topnie/automated_greenhouse/images/render1.png

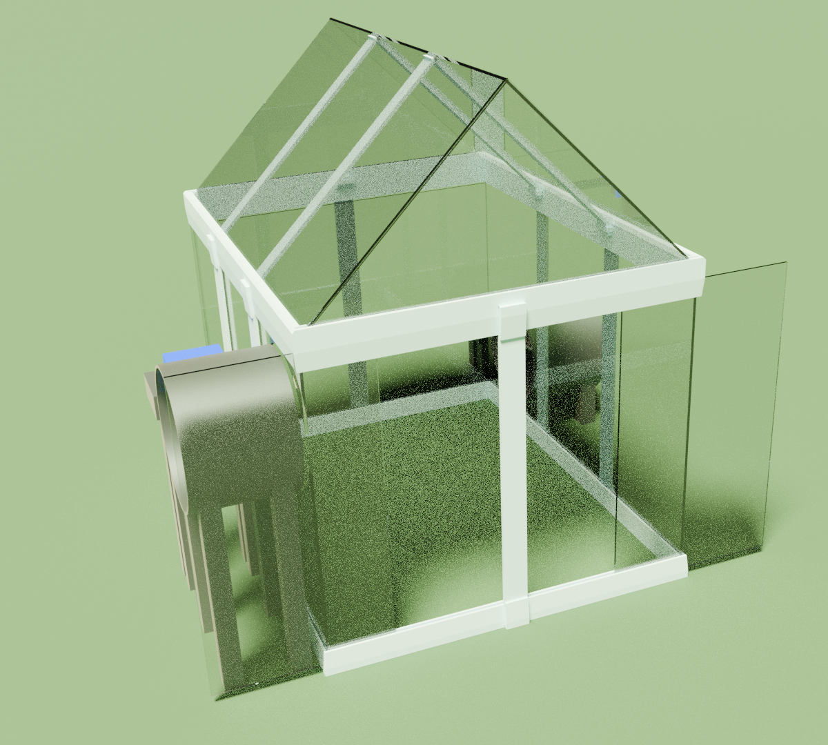
images/render1.png
