topnie/automated_greenhouse/images/render2.png

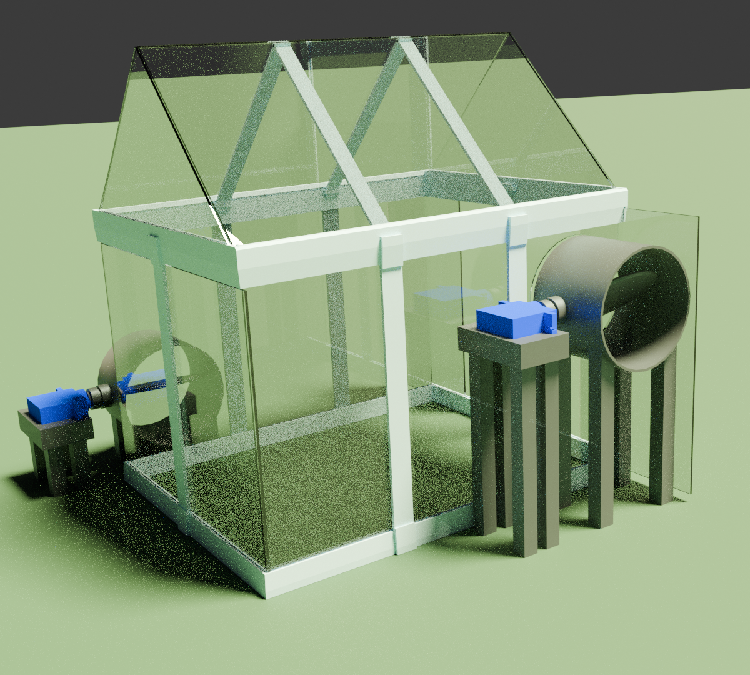
images/render2.png
