topnie/automated_greenhouse/images/render3.png

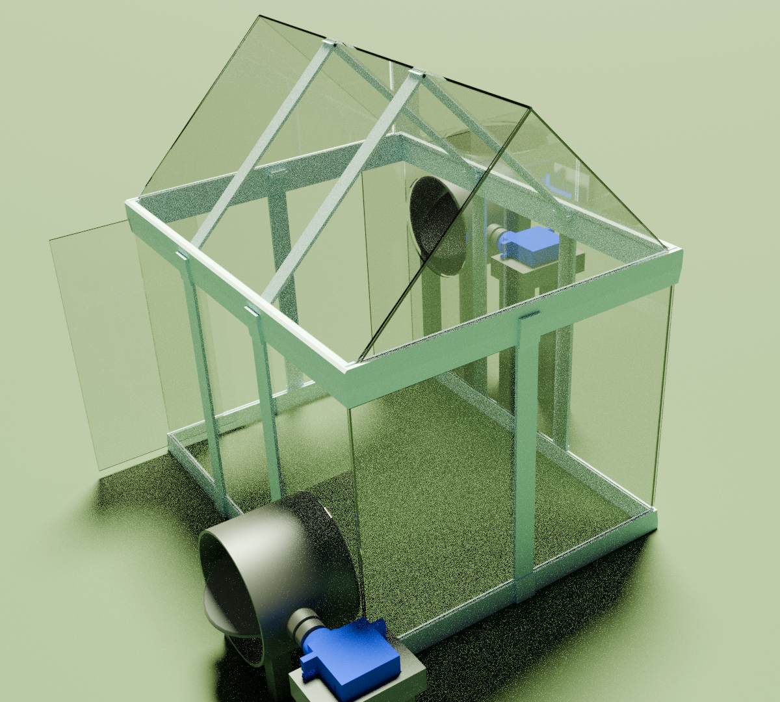
images/render3.png
