topnie/automated_greenhouse/images/side_view.jpg

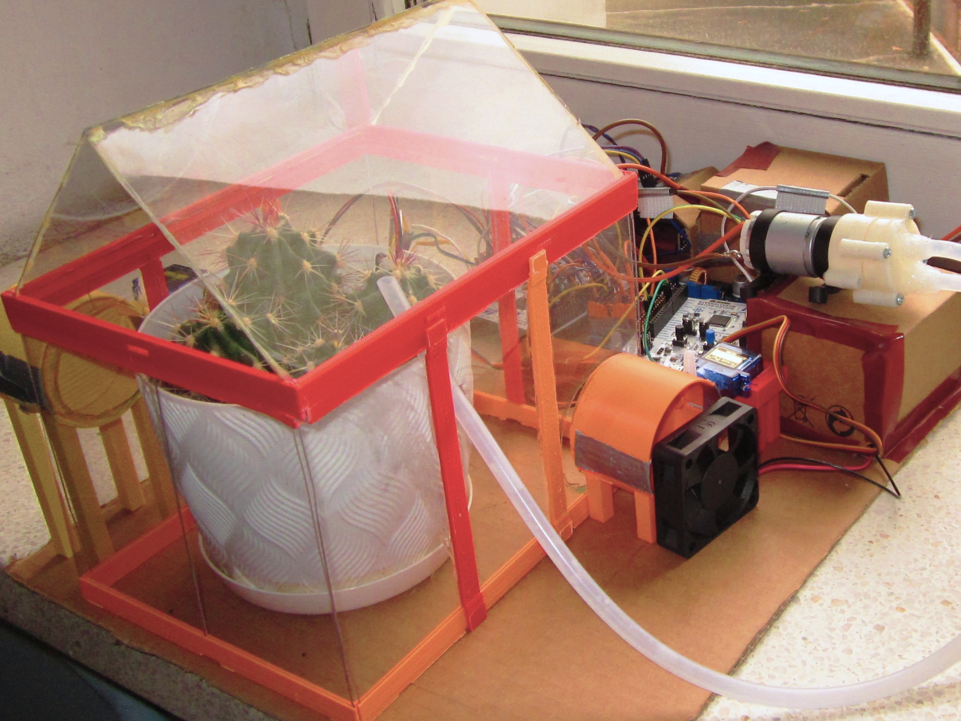
images/side_view.jpg
