topnie/automated_greenhouse/parts/bom.csv

item | part_name | manufacturer | model_or_part_number | quantity | purchase_unit
1 | STM32 NUCLEO-G431RB Development Board | STMicroelectronics | NUCLEO-G431RB | 2 | pcs
2 | Waveshare SN65HVD230 CAN Bus Transceiver Module | Waveshare | SN65HVD230 / 3945 | 2 | pcs
3 | BH1750 Digital Ambient Light Sensor Module |  | BH1750 | 1 | pcs
4 | DFRobot SHT31-F Digital Temperature and Humidity Sensor (I2C) | DFRobot | SEN0334 | 1 | pcs
5 | Cytron Maker Capacitive Soil Moisture Sensor | Cytron | Maker Soil Moisture | 1 | pcs
6 | XL4015 DC-DC Buck Converter, 1.3–36 V, 5 A |  | XL4015 | 1 | pcs
7 | 12 V Liquid Pump, 110 L/h, 7 mm Hose Connection |  | 12 V / 110 L/h / 7 mm | 1 | pcs
8 | 1N5819 Schottky Diode, 1 A, 40 V |  | 1N5819 | 2 | pcs
9 | DC Female Barrel Jack Socket, 5.5 × 2.1 mm with Screw Terminals |  | 5.5 × 2.1 mm DC jack | 1 | pcs
10 | MW Power 12 V / 5 A (60 W) Power Supply, 5.5 × 2.1 mm DC Plug | MW Power | 12 V / 5 A / 60 W | 1 | pcs
11 | SUNON MF50151VX-1000U-A99 Fan, 12 V, 50 × 50 × 15 mm | SUNON | MF50151VX-1000U-A99 | 1 | pcs
12 | SG90 Micro Servo, 180° |  | SG90 | 2 | pcs
13 | IRLB8721PBF N-Channel Power MOSFET |  | IRLB8721PBF | 2 | pcs
14 | BME280 Temperature, Humidity and Pressure Sensor Module (I2C/SPI) |  | BME280 | 1 | pcs
15 | Waveshare USB-to-UART TTL Converter, USB Type-C, PL2303 | Waveshare | PL2303 / 20645 | 1 | pcs
