topnie/automated_greenhouse/3d_models/vent_servo_holder_tall.stl

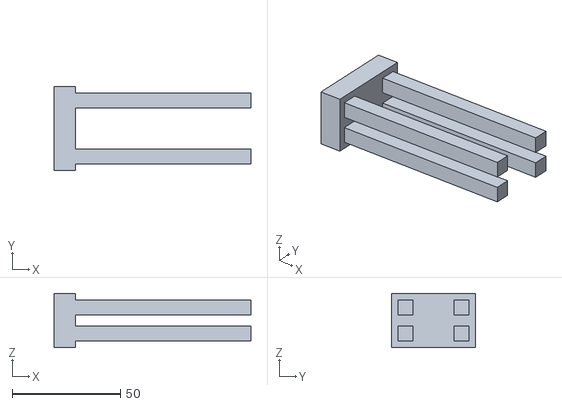
[picture p7: CAD file, 2026-10-28]
3d_models/vent_servo_holder_tall.stl
91.0 x 39.0 x 25.0
