topnie/automated_greenhouse/3d_models/frame_bottom.stl

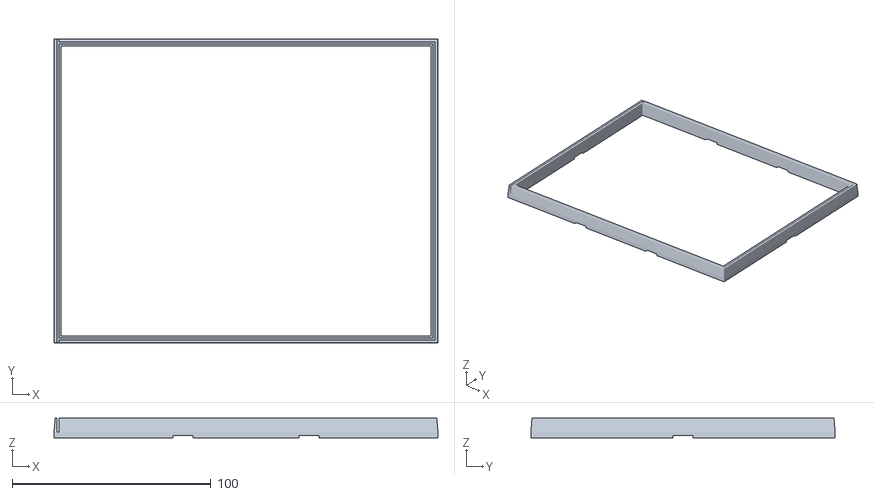
[picture p8: CAD file, 2026-10-28]
3d_models/frame_bottom.stl
193.0 x 153.0 x 10.0
