topnie/automated_greenhouse/3d_models/frame_top.stl

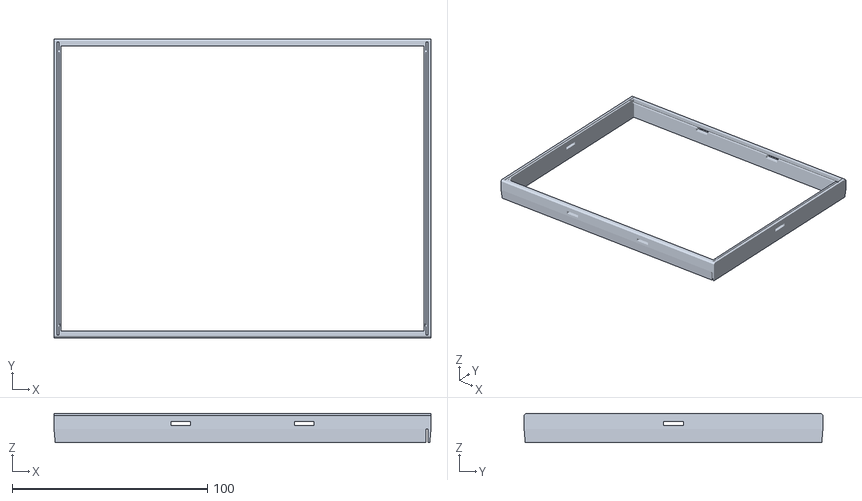
[picture p9: CAD file, 2026-10-28]
3d_models/frame_top.stl
193.0 x 153.0 x 15.0
