topnie/automated_greenhouse/3d_models/vent_tunnel_tall.stl

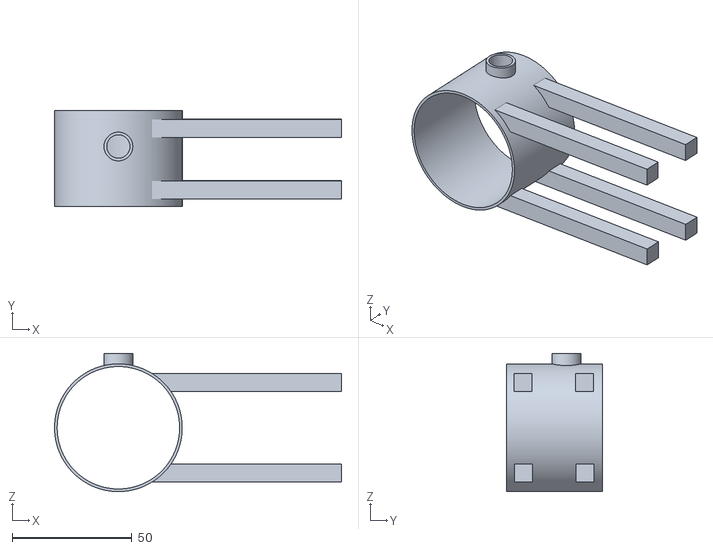
[picture p10: CAD file, 2026-10-28]
3d_models/vent_tunnel_tall.stl
119.6 x 40.0 x 57.6
