topnie/automated_greenhouse/3d_models/vent_servo_holder_short.stl

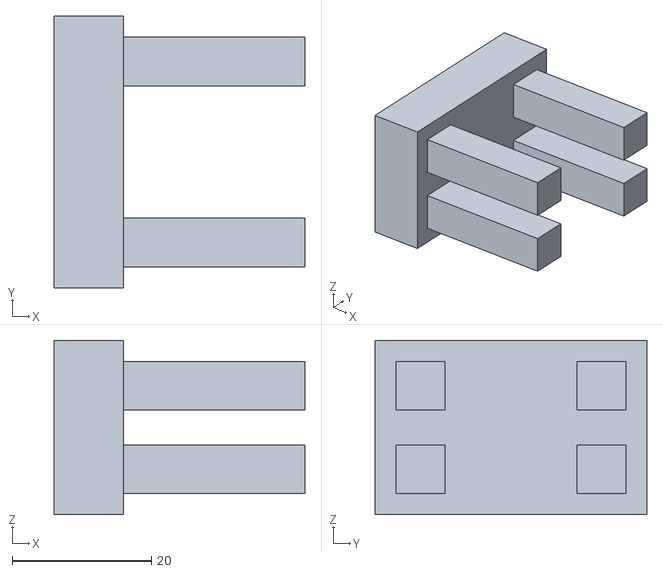
[picture p11: CAD file, 2026-10-28]
3d_models/vent_servo_holder_short.stl
36.0 x 39.0 x 25.0
