topnie/automated_greenhouse/3d_models/vent_paddle.stl

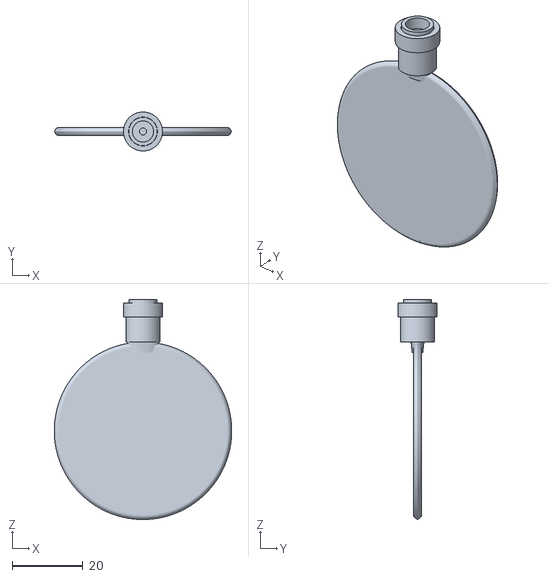
[picture p12: CAD file, 2026-10-28]
3d_models/vent_paddle.stl
50.0 x 11.0 x 62.0
