topnie/automated_greenhouse/3d_models/frame_beam.stl

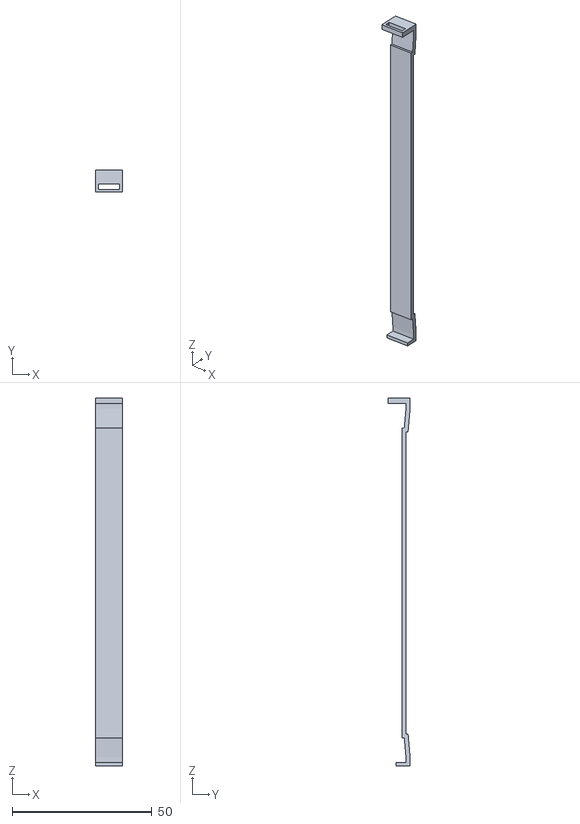
[picture p13: CAD file, 2026-10-28]
3d_models/frame_beam.stl
9.50 x 8.00 x 131.7
