topnie/automated_greenhouse/3d_models/vent_tunnel_short.stl

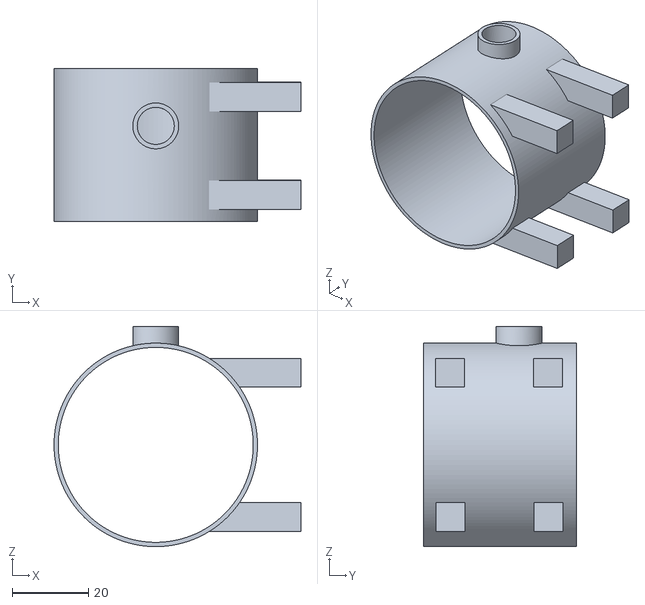
[picture p14: CAD file, 2026-10-28]
3d_models/vent_tunnel_short.stl
64.6 x 40.0 x 57.6
