topnie/automated_greenhouse/kicad_schematics/greenhouse_schematic.pdf

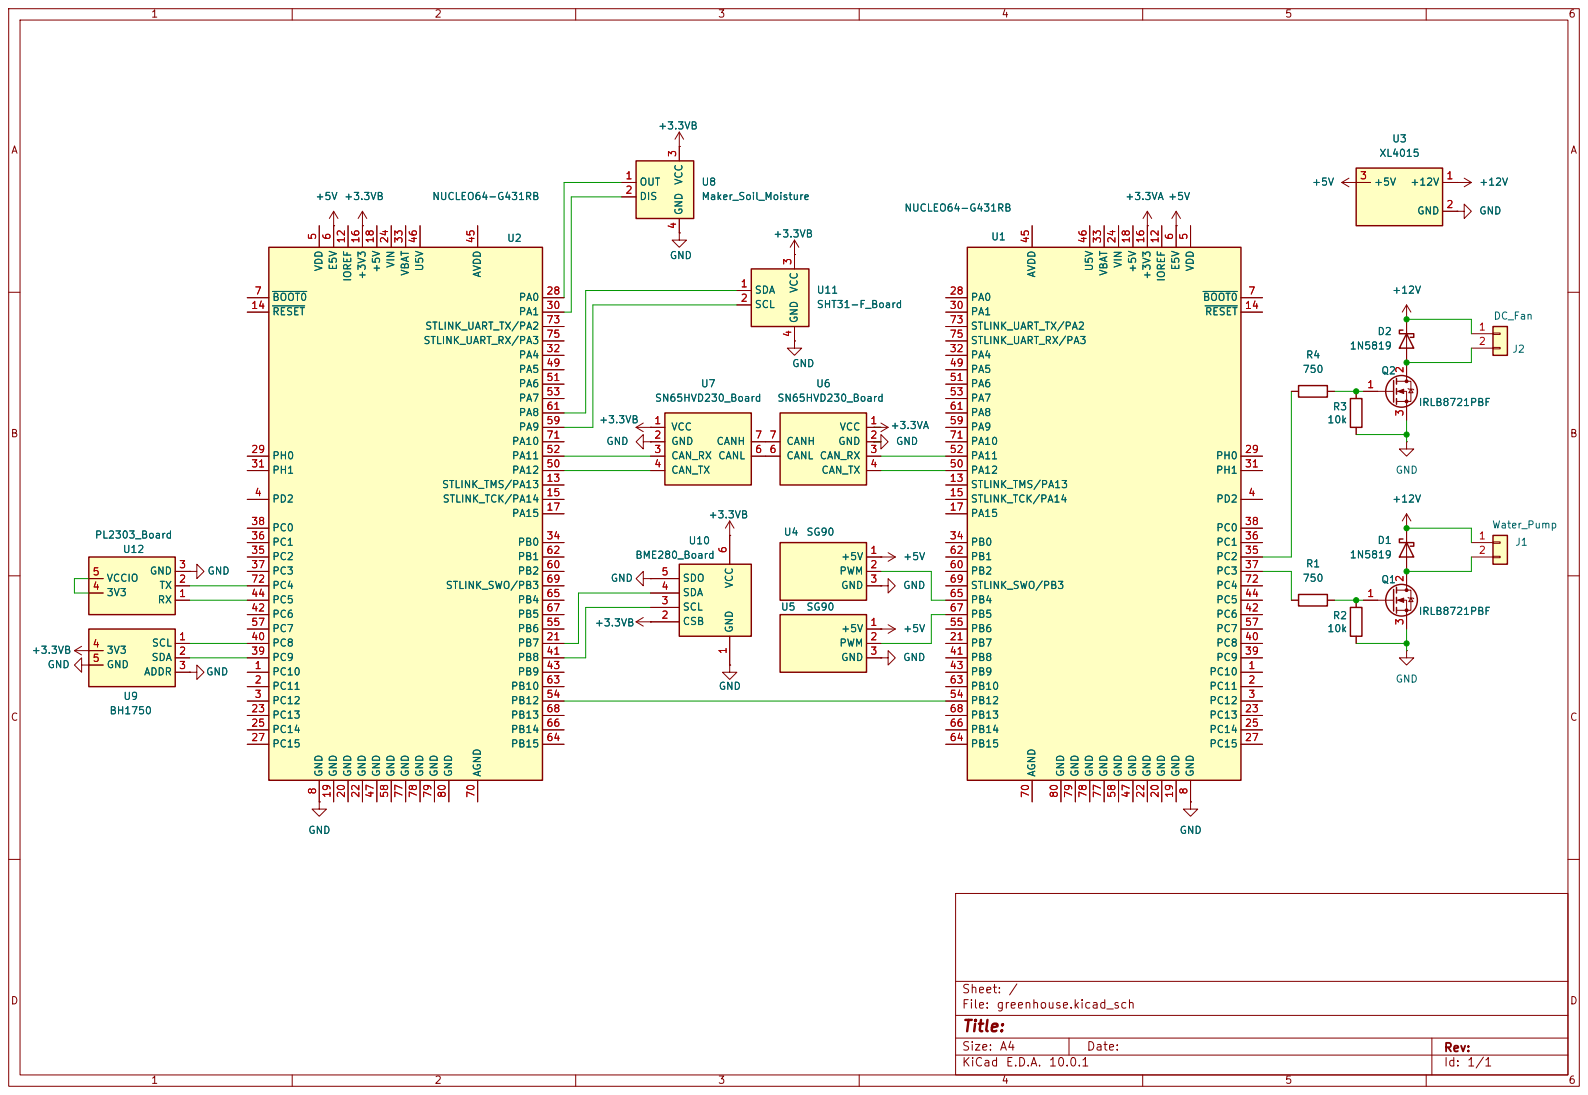
[picture p15: page 1]

Size: A4 | Rev:
KiCad E.D.A. 10.0.1 | Id: 1/1
