topnie/automated_greenhouse/kicad_schematics/greenhouse.kicad_sch

## KiCad design kicad_schematics/greenhouse.kicad_sch (2026-10-28)

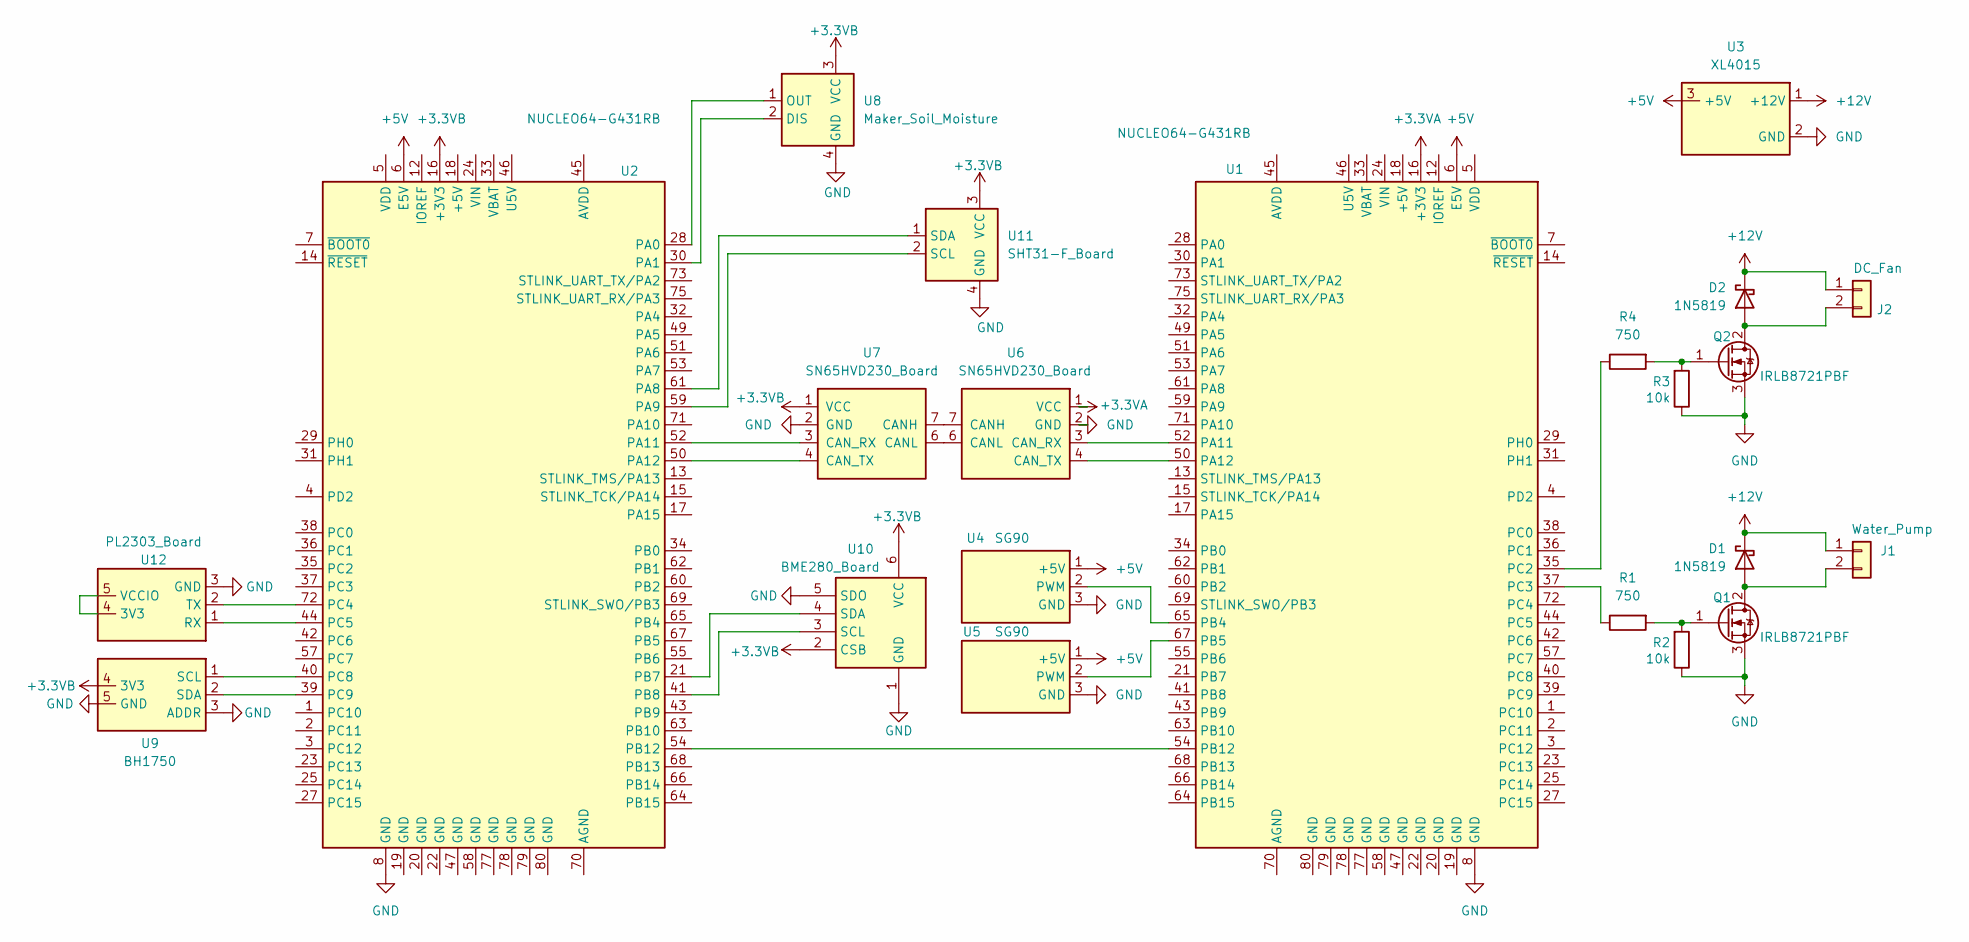
[picture p16: schematic greenhouse.kicad_sch]

Parts:
D1, D2: 1N5819; D_DO-41_SOD81_P10.16mm_Horizontal
J1: Water_Pump
J2: DC_Fan
Q1, Q2: IRLB8721PBF; TO-220-3_Vertical
R1, R4: 750
R2, R3: 10k
U1, U2: NUCLEO64-G431RB
U3: XL4015
U4, U5: SG90
U6, U7: SN65HVD230_Board
U8: Maker_Soil_Moisture
U9: BH1750
U10: BME280_Board
U11: SHT31-F_Board
U12: PL2303_Board

Connections:
+3.3VA: U1.16 (+3V3), U6.1 (VCC)
+3.3VB: U2.16 (+3V3), U7.1 (VCC), U8.3 (VCC), U9.4 (3V3), U10.2 (CSB), U10.6 (VCC), U11.3 (VCC)
+5V: U1.6 (E5V), U2.6 (E5V), U3.3 (+5V), U4.1 (+5V), U5.1 (+5V)
+12V: D1.1 (K), D2.1 (K), J1.1, J2.1, U3.1 (+12V)
GND: Q1.3 (S), Q2.3 (S), R2.1, R3.1, U1.8 (GND), U2.8 (GND), U3.2 (GND), U4.3 (GND), U5.3 (GND), U6.2 (GND), U7.2 (GND), U8.4 (GND), U9.3 (ADDR), U9.5 (GND), U10.1 (GND), U10.5 (SDO), U11.4 (GND), U12.3 (GND)
unnamed: D1.2 (A), J1.2, Q1.2 (D)
unnamed: D2.2 (A), J2.2, Q2.2 (D)
unnamed: Q1.1 (G), R1.2, R2.2
unnamed: Q2.1 (G), R3.2, R4.2
unnamed: R1.1, U1.37 (PC3)
unnamed: R4.1, U1.35 (PC2)
unnamed: U1.50 (PA12), U6.4 (CAN_TX)
unnamed: U1.52 (PA11), U6.3 (CAN_RX)
unnamed: U1.54 (PB12), U2.54 (PB12)
unnamed: U1.65 (PB4), U4.2 (PWM)
unnamed: U1.67 (PB5), U5.2 (PWM)
unnamed: U2.28 (PA0), U8.1 (OUT)
unnamed: U2.30 (PA1), U8.2 (DIS)
unnamed: U2.39 (PC9), U9.2 (SDA)
unnamed: U2.40 (PC8), U9.1 (SCL)
unnamed: U2.50 (PA12), U7.4 (CAN_TX)
unnamed: U2.52 (PA11), U7.3 (CAN_RX)
unnamed: U6.6 (CANL), U7.6 (CANL)
unnamed: U6.7 (CANH), U7.7 (CANH)
unnamed: U2.41 (PB8), U10.3 (SCL)
unnamed: U2.21 (PB7), U10.4 (SDA)
unnamed: U2.61 (PA8), U11.1 (SDA)
unnamed: U2.59 (PA9), U11.2 (SCL)
unnamed: U2.44 (PC5), U12.1 (RX)
unnamed: U2.72 (PC4), U12.2 (TX)
unnamed: U12.4 (3V3), U12.5 (VCCIO)
