topnie/automated_greenhouse/src/firmware/controller/controller.ioc

Mcu.UserName=STM32G431RBTx
PA11.Signal=FDCAN1_RX
PA12.Signal=FDCAN1_TX
PB12.Signal=GPXTI12
PB4.Signal=S_TIM3_CH1
PB5.Signal=S_TIM3_CH2
