topnie/automated_greenhouse/(commit log)

2026-10-28 add bill of materials
2026-10-28 add kicad schematics
2026-10-28 add prototype photos
